j--s/ptbmk2/figs/ptbmk2_protodune_io_firm.pdf

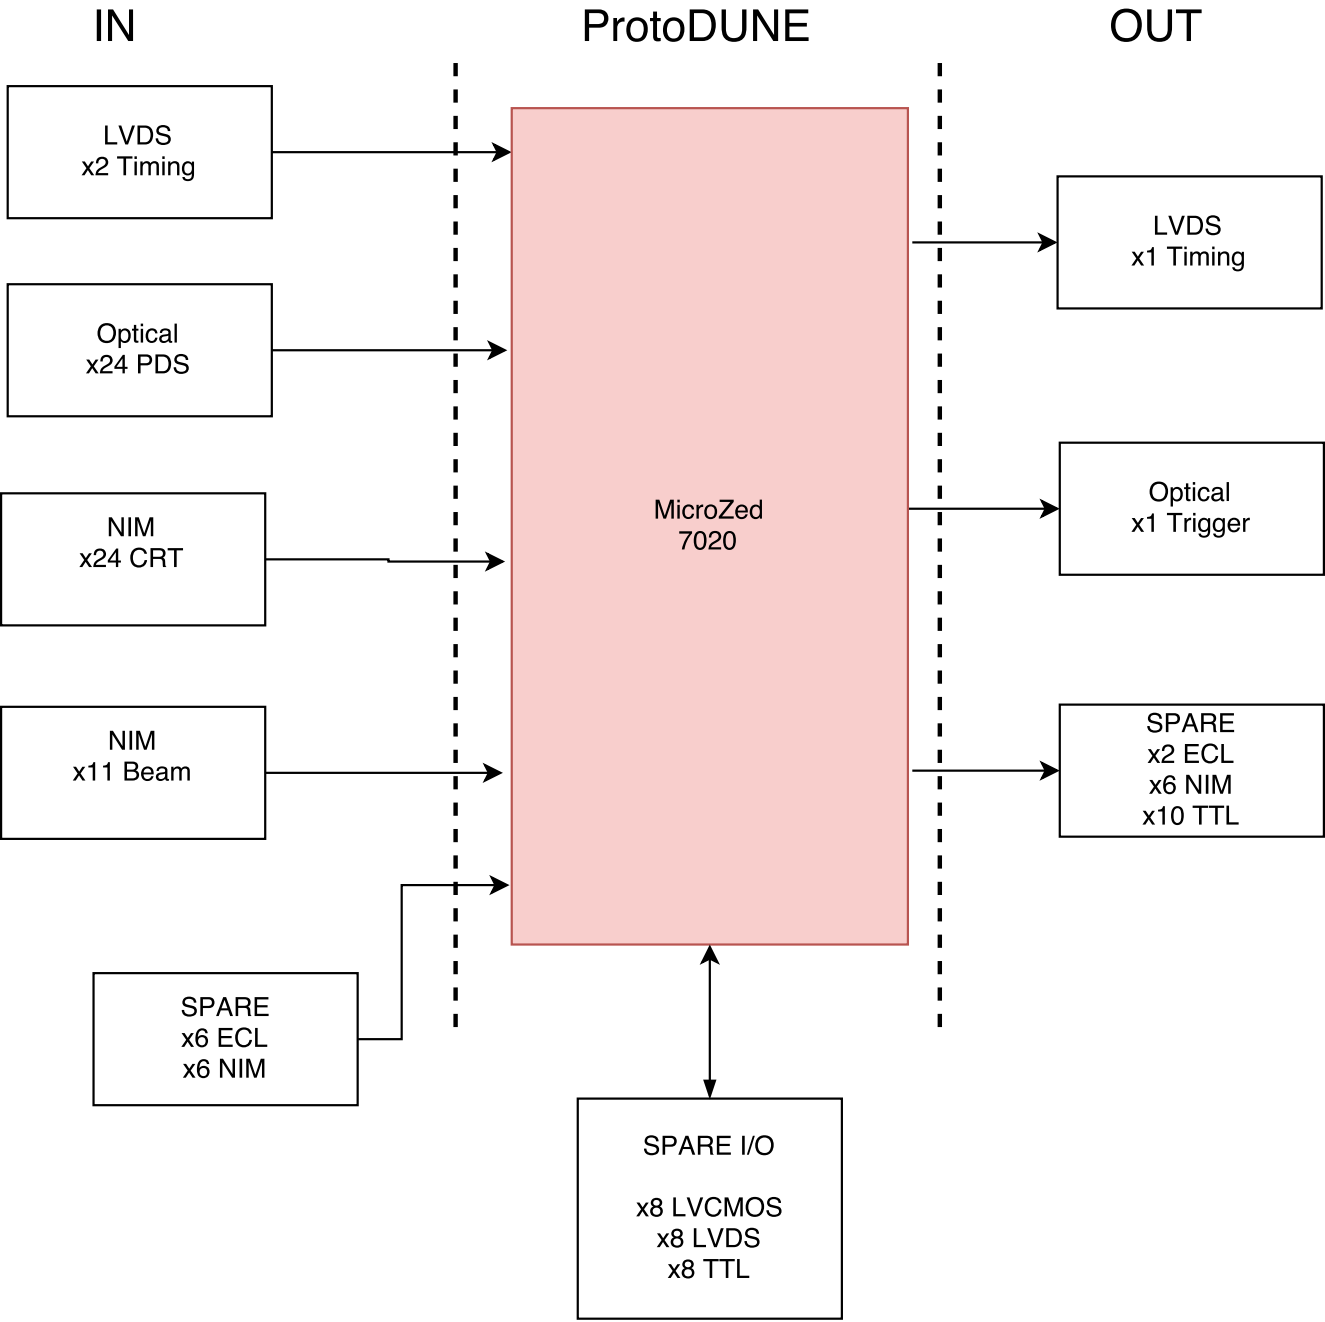
[picture p14: page 1]
